ocramuni/iot_project/report/images/voltage_divider.pdf

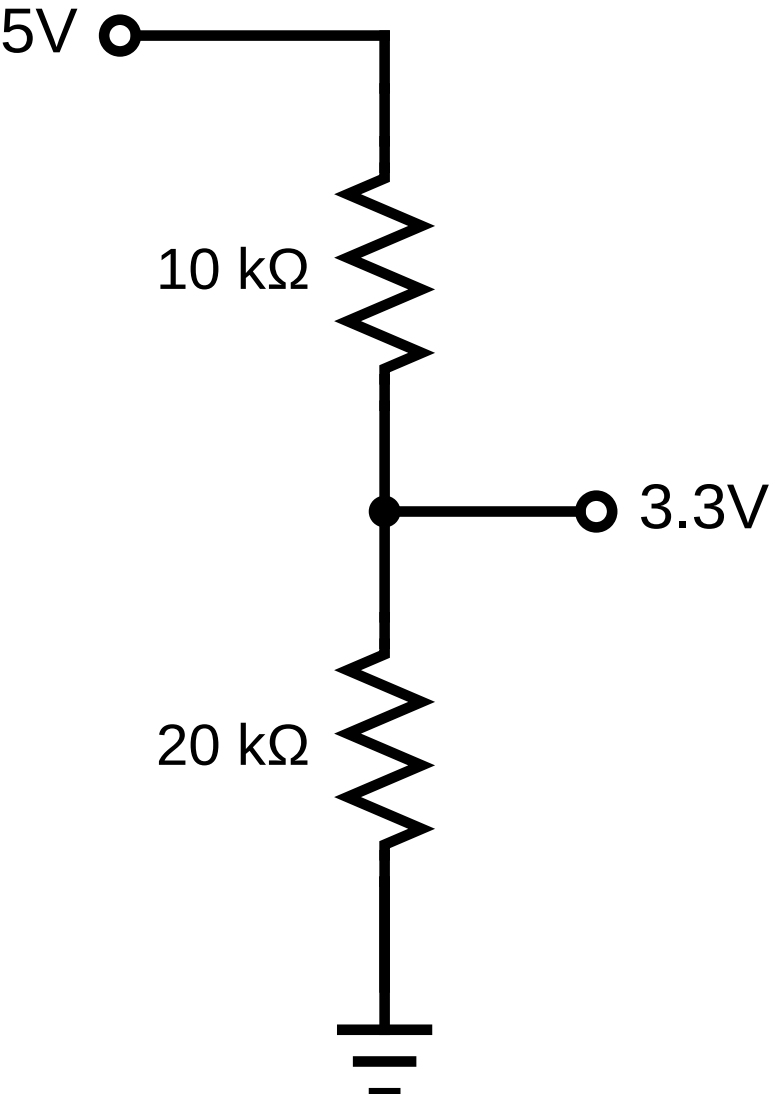
[picture p5: page 1]
