ocramuni/iot_project/report/images/power_meter_bb.pdf

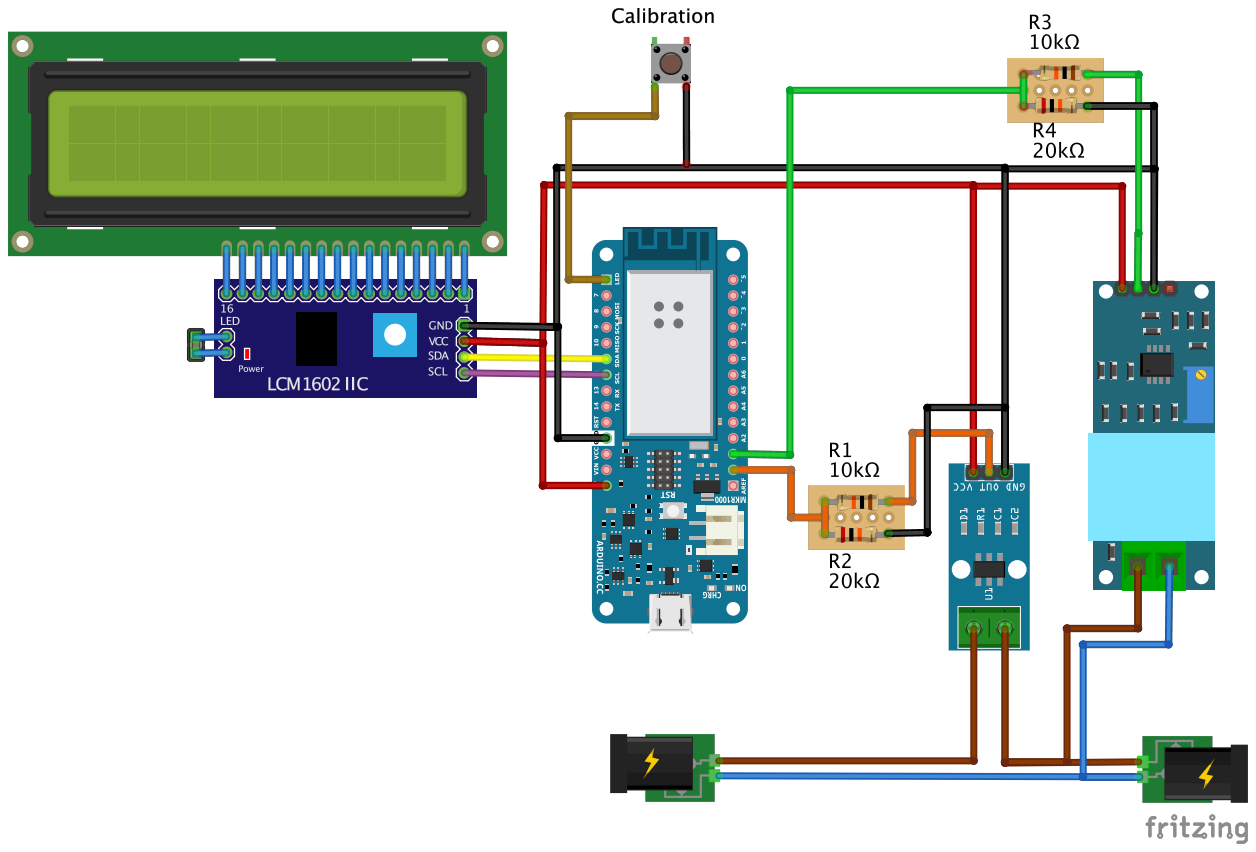
[picture p6: page 1]
