ocramuni/iot_project/(list of files, drawings)

Other design files:
report/images/power_meter.fzz
