ocramuni/iot_project/(commit log)

2022-10-18 Arduino code.
2022-10-18 Added calibration button.
2022-10-23 Added Arduino references.
2022-10-24 Added Fritzing schema source file.
    [power_meter.fzz]
